trandat09062003/Smart_Helmet/SCHEMATIC_PCB_VIEWER.html

🪖

# SMART HELMET 360° - CARRIER BOARD CAD & BOM VIEWER

Mũ Bảo Hiểm Thông Minh Cho Người Khiếm Thị • Mạch Phụ Trợ RPi & 4 Camera 360°

🟢 THƯ VIỆN CHUẨN: THU_VIEN_ALTIUMM2.IntLib 🏠 Trang Kế Hoạch 🚀 Code Nạp Pi

## 🎯 CẨM NANG TRA CỨU LINH KIỆN: ƯU TIÊN THU_VIEN_ALTIUMM2.IntLib

🟢 Nhóm 1 - Có sẵn trong thư viện Altium của bạn (85% linh kiện): Các linh kiện như IC Buck LM2596/2576, IC đệm ULN2003, Transistor S8050, Còi Buzzer, Cuộn cảm 33uH, Tụ lọc nguồn, Header cắm motor/camera đã có sẵn trong THU_VIEN_ALTIUMM2.IntLib. Chỉ cần bấm nút 📋 Copy rồi dán vào ô tìm kiếm bảng Components trong Altium là lấy ra ngay!

🟠 Nhóm 2 - Module bổ sung đặc thù (Camera Hub & Cảm biến ToF): IC Hub USB 4 cổng (FE1.1s / GL850G) và Cảm biến Laser VL53L0X là dạng module hoặc IC chuyên dụng, đã được gán sẵn footprint chuẩn SMD/DIP để vẽ schematic cực nhanh.

📥 Xuất File Excel / BOM CSV Tổng cộng: 26 linh kiện

🔍

Tất Cả ⚡ Nguồn 5V/5A 🖥️ Pi 4/5 HAT 📳 4 Motor Rung 🚨 Còi & SOS 📷 4 Cam USB Hub 🛰️ GPS & ToF 🧲 R - C - Diode | 🟢 Có trong THU_VIEN_ALTIUMM2 🟠 Module Bổ Sung

Ký Hiệu | Tên Linh Kiện & Chức Năng | Nguồn Thư Viện | TỪ KHÓA GÕ VÀO ALTIUM | Thư Viện (.SchLib) | Footprint PCB | SL | Gợi Ý / Hướng Dẫn Mua & Hàn

📐 Sơ Đồ Khối Nguyên Lý Chip-Level (Smart Helmet Carrier Board)

🔍 Phóng To (+) Thu Nhỏ (-) ↺ Mặc Định

🖨️ Bố Trí Mạch In PCB 2 Lớp (70mm x 60mm Compact Carrier HAT)

Lớp Top (Đỏ) Lớp Bottom (Xanh) Lớp Chữ (Silk) | 🟢 Xanh Lá ⚫ Đen Nhám 🔵 Xanh Dương

## 🔌 BẢNG ÁNH XẠ NỐI DÂY 40 CHÂN RASPBERRY PI VỚI BO MẠCH PHỤ TRỢ MŨ

Chân Vật Lý | Tên Chân BCM | Tên Net Thiết Kế | Kiểu Tín Hiệu | Mục Đích & Kết Nối Thiết Bị
Pin 2, 4 | 5V | +5V_POWER | Nguồn Vào (Power In) | Nhận nguồn 5.0V / 5A ổn áp từ khối Buck LM2596 để nuôi toàn bộ mạch Raspberry Pi và CPU.
Pin 6, 9, 14, 20 | GND | GND | Mass Chung (Ground) | Đường nối đất chung toàn hệ thống (Pi, Camera Hub, Motor driver, GPS, Còi).
Pin 11 | GPIO 17 | VIB_FRONT | GPIO Output (PWM) | Nối chân IN1 của ULN2003 kích rung Motor Trước trán khi AI phát hiện vật cản trước mặt.
Pin 13 | GPIO 27 | VIB_RIGHT | GPIO Output (PWM) | Nối chân IN2 của ULN2003 kích rung Motor Thái dương phải khi xe cộ tiếp cận bên phải.
Pin 15 | GPIO 22 | VIB_REAR | GPIO Output (PWM) | Nối chân IN3 của ULN2003 kích rung Motor Gáy sau khi có xe vượt hoặc vật cản sau lưng.
Pin 16 | GPIO 23 | VIB_LEFT | GPIO Output (PWM) | Nối chân IN4 của ULN2003 kích rung Motor Thái dương trái khi có chướng ngại vật bên trái.
Pin 18 | GPIO 24 | BUZZER_CTRL | GPIO Output | Nối chân IN5 của ULN2003 kích còi Buzzer 5V kêu dồn dập khi gặp nguy cấp hoặc bấm nút SOS.
Pin 22 | GPIO 25 | BTN_SOS | GPIO Input (Pull-Up) | Nối nút bấm SOS khẩn cấp trên vành mũ (nhấn nối đất GND). Tích hợp tụ 100nF lọc chống dội.
Pin 8, 10 | UART TX / RX | UART_GPS | UART Serial (9600) | Kết nối module GPS NEO-6M/8M để thu nhận tọa độ kinh độ/vĩ độ gửi về cho người thân khi SOS.
Pin 3, 5 | I2C1 SDA / SCL | I2C_TOF | I2C Bus (Fast Mode) | Kết nối cảm biến khoảng cách Laser ToF VL53L0X đo khoảng cách vật cản chính xác cự ly gần.

## 💡 NGUYÊN LÝ LỰA CHỌN LINH KIỆN & THIẾT KẾ PHẦN CỨNG MŨ BẢO HIỂM

Luận cứ khoa học và tính toán thực tế cho ban giám khảo cuộc thi Nghiên cứu Khoa học Kỹ thuật (KHKT).

⚡

Tại Sao Dùng Chip Buck LM2596S-5.0 / XL4015 Thay Vì IC Tuyến Tính 7805?

Raspberry Pi 4/5 cùng 4 mắt camera USB khi chạy thuật toán YOLOv8 tiêu thụ dòng điện trung bình từ 2.5A đến 3.5A. Nếu dùng IC tuyến tính 7805 hạ áp từ Pin 7.4V xuống 5V, công suất tỏa nhiệt lãng phí là $P = (7.4V - 5V) \times 3A = 7.2W$ sẽ gây nóng bỏng mũ và nhanh cạn pin. IC Buck xung LM2596/XL4015 đạt hiệu suất > 88%, mạch mát mẻ, kéo dài thời lượng pin của mũ lên hơn 3-4 giờ sử dụng liên tục.

📳

Tại Sao Bắt Buộc Dùng IC Đệm ULN2003A Điều Khiển 4 Motor Rung?

Chân GPIO của vi xử lý Raspberry Pi chỉ chịu dòng tối đa 16mA. Mỗi motor rung đồng xu mini khi quay tiêu thụ dòng 60mA - 90mA và khi ngắt dòng sinh ra điện áp cảm ứng ngược cực lớn ($\mathcal{E} = -L \frac{di}{dt}$) làm cháy cổng GPIO ngay lập tức. IC đệm ULN2003A chịu dòng tới 500mA/kênh và tích hợp sẵn diode bảo vệ dập xung ngược, giúp triệt tiêu xung gai điện áp, bảo vệ vi mạch Raspberry Pi an toàn tuyệt đối.

📷

Tại Sao Dùng IC Hub USB 4 Cổng FE1.1s Chuyên Dụng?

Để bao quát toàn cảnh $360^\circ$ cần 4 mắt camera góc rộng. Thay vì phải cắm 4 dây USB lòng thòng vào từng cổng của Raspberry Pi làm vướng víu vành mũ, mạch tích hợp chip FE1.1s (SSOP-28) làm bộ gộp trung tâm ngay trên mũ. Chuẩn UVC tự động nén phần cứng MJPEG giúp truyền 4 luồng hình ảnh mượt mà qua duy nhất 1 cáp USB về bo mạch xử lý, giảm tối đa độ rung lắc dây khi người dùng đi lại.

🛡️

Tại Sao Cần Mạch Lọc RC Chống Dội Cho Nút SOS?

Nút bấm cơ khí khi ấn luôn xảy ra hiện tượng dội phím (Contact Bouncing) tạo ra hàng chục xung nhiễu trong vài mili-giây. Mạch tích hợp điện trở kéo lên $10\text{k}\Omega$ kết hợp tụ gốm $100\text{nF}$ tạo thành bộ lọc thông thấp RC có hằng số thời gian $\tau = R \times C = 1\text{ms}$, triệt tiêu hoàn toàn xung nhiễu vật lý, giúp chương trình Python nhận diện chính xác thao tác bấm giữ khẩn cấp của người khiếm thị mà không bao giờ bị báo động giả.

📋 Đã sao chép từ khóa vào Clipboard!

Smart Helmet 360° • Thiết Kế Phần Cứng & BOM Altium Dành Cho Cuộc Thi Nghiên Cứu KHKT 2026

Thư mục dự án: C:\Users\Public\Documents\Altium\08052026\Smart_helmet\
