trandat09062003/Smart_Helmet/(list of files, drawings)

Other design files:
Smart_Helmet/Smart_Helmet.PrjPcb
Smart_Helmet/Smart_Helmet.SchDoc
