trandat09062003/Smart_Helmet/(commit log)

2026-10-20 Initial commit: Smart Helmet 360 system on Raspberry Pi 4 (Ubuntu 22.04), hardware carrier board, and setup scripts
    [Smart_Helmet.PrjPcb, Smart_Helmet.SchDoc]
2026-11-09 Update Smart Helmet Pi software from Raspberry Pi
    - Implement Continuous Low-FPS V4L2-MMAP streaming to prevent USB Hub chip timeout (-110)
    - Add Triple-Camera spatial 360 mapping (Front, Rear, Right) with Left-zone spatial partitioning
    - Optimize OpenCV and PyTorch CPU thread allocation for Pi 4
    - Route ALSA voice alerts to audio card 0 to avoid webcam microphone conflicts
    - Add utility scripts: run.sh, start_background.sh, status.sh, stop.sh
    - Update documentation and Web Dashboard streaming view
    [ai_detector.py, camera_manager.py, config.py, main.py, sos_manager.py, test_cameras.py, voice_alert.py, web_server.py]
2026-11-09 Clean up redundant files, caches, and outdated 4-camera documentation
2026-11-09 Support 3-Camera Equilateral Triangle (120°) spatial 360 architecture
    - Add TRI_120 layout in config.py with FRONT (0°), REAR_RIGHT (120°), REAR_LEFT (240°)
    - Update spatial partition in ai_detector.py to map 3 cameras seamlessly to 4 Haptic motors (Front, Right, Rear, Left)
    - Update camera_manager.py and web_server.py to render dynamic multi-camera feeds and telemetry
    - Add interactive 3-Cam Triangle simulation mode in index.html
    - Update test_cameras.py and deployment documentation
